Scarzy/3YP-Noise-Cancelling-Headphones/reports/final_report/pcbcostings.tex

The costings of the components for the PCB.
The total cost came to \pounds196.90.

\begin{table}[H]
	\centering
	\begin{tabular}[c]{| l | l | l | p{50px} | l | l | l |}
		\hline
		\multicolumn{7}{|l|}{MicroControllers} \\
		\hline
		Item	& Component Name& Supplier & Part	& No.	& Unit  & Line \\
		\hline
		DSP	& tms320c6713bpyp200	& Farnell	& 1214441	& 1	& \pounds24.51	& \pounds29.42	\\
		Codec	& wm8988		& Farnell	& 1776294	& 2	& \pounds2.84	& \pounds6.82	\\
		Clock Gen.	& bu2796	& Farnell	& 1716138	& 2	& \pounds0.83	& \pounds1.99	\\
		Dual Op-Amp	& ap358sg	& Farnell	& 1825347	& 10	& \pounds0.08	& \pounds0.96	\\
		\hline
		\multicolumn{7}{|l|}{}\\
		\hline
		\multicolumn{7}{|l|}{Resistors} \\
		\hline
		Item	& Component Name& Supplier & Part	& No.	& Unit  & Line \\
		\hline
		10K\textohm	& r-10k	& Farnell	& 1469748	& 50	& \pounds0.013	& \pounds0.78	\\
		8K2\textohm	& r-8k2	& Farnell	& 9334904	& 50	& \pounds0.01	& \pounds0.60	\\
		1K\textohm	& r-1k	& Farnell	& 9332383	& 50	& \pounds0.025	& \pounds1.50	\\
		120\textohm	& r-120	& Farnell	& 9337059	& 50	& \pounds0.011	& \pounds0.66	\\
		55\textohm	& r-55	& Farnell	& 1500641	& 50	& \pounds0.015	& \pounds0.90	\\
		33\textohm	& r-33	& Farnell	& 1500704	& 50	& \pounds0.016	& \pounds0.96	\\
		8\textohm	& r-8	& Farnell	& 1577385	& 50	& \pounds0.047	& \pounds2.82	\\
		\hline
		\multicolumn{7}{|l|}{}\\
		\hline
		\multicolumn{7}{|l|}{Capacitors} \\
		\hline
		Item	& Component Name& Supplier & Part	& No.	& Unit  & Line  \\
		\hline
		220uF	& c-220u& Farnell	& 1865004	& 5	& \pounds1.10	& \pounds6.60	\\
		10uF	& c-10u	& Farnell	& 1658212	& 10	& \pounds0.115	& \pounds1.38	\\
		4u7F	& c-4u7	& Farnell	& 1759427	& 100	& \pounds0.018	& \pounds2.16	\\
		1uF	& c-1u	& Farnell	& 1759398	& 100	& \pounds0.006	& \pounds0.72	\\
		100nF	& c-0u1	& Farnell	& 1759123	& 100	& \pounds0.005	& \pounds0.60	\\
		1nF	& c-1n	& Farnell	& 1759088	& 100	& \pounds0.005	& \pounds0.60	\\
		8pF	& c-8p	& Farnell	& 1759051	& 100	& \pounds0.006	& \pounds0.72	\\
		\hline
		\multicolumn{7}{|l|}{}\\
		\hline
		\multicolumn{7}{|l|}{Connectors} \\
		\hline
		Item	& Component Name& Supplier & Part	& No.	& Unit  & Line \\
		\hline
		2 pin	& cn-header2	& Farnell	& 1248140	& 10	& \pounds0.106	& \pounds1.24	\\
		8 pin	& cn-header2x4	& Farnell	& 1759051	& 8	& \pounds0.98	& \pounds9.41	\\
		14 pin	& cn-header2x7-box	& Farnell	& 8395926	& 2	& \pounds0.72	& \pounds1.73	\\
		Jack	& cn-st-jack	& Farnell	& 1217016	& 2	& \pounds1.36	& \pounds3.26	\\
		\hline
		\multicolumn{7}{|l|}{}\\
		\hline
		\multicolumn{7}{|l|}{Miscellaneous} \\
		\hline
		Item	& Component Name& Supplier & Part	& No.	& Unit  & Line \\
		\hline
		3.3V Regulator	& ld1117s33	& Farnell	& 1467779	& 2	& \pounds0.71	& \pounds1.71	\\
		1.2V Regulator	& ld1117s12	& Farnell	& 1467778	& 2	& \pounds1.02	& \pounds2.45	\\
		12MHz Crystal	& xtal-12m	& Farnell	& 1652551	& 2	& \pounds0.32	& \pounds0.77	\\
		Red LED		& led-red-0603	& Farnell	& 1465988	& 10	& \pounds0.23	& \pounds2.76	\\
		PCB		&	 	& PCB-Train	& 		& 2	& \pounds78.16	& \pounds78.16	\\
		JTAG Cable	&		& FTDI		& C232HM-DDHSL-0& 1	& \pounds18.50	& \pounds22.20	\\
		Headphones	&		& Play.com	& 3432806	& 1	& \pounds12.99	& \pounds12.99	\\
		\hline
	\end{tabular}
	\caption{Costs involved in the PCB production. Prices correct at time of purchase, line cost includes VAT, unit cost may not}
	\label{tab:pcbcostings}
\end{table}
