Scarzy/3YP-Noise-Cancelling-Headphones/reports/final_report/schematicappendix.tex

\label{appendix:schematics}
The schematics of the produced PCB.

\includepdf[pages=-,fitpaper=true,pagecommand={\thispagestyle{plain}}]{./sch/overview.pdf}
\includepdf[pages=-,fitpaper=true,pagecommand={\thispagestyle{plain}}]{./sch/codec.pdf}
\includepdf[pages=-,fitpaper=true,pagecommand={\thispagestyle{plain}}]{./sch/power.pdf}
\includepdf[pages=-,fitpaper=true,pagecommand={\thispagestyle{plain}}]{./sch/dsp.pdf}
\includepdf[pages=-,fitpaper=true,pagecommand={\thispagestyle{plain}}]{./sch/analogue.pdf}
\includepdf[pages=-,fitpaper=true,pagecommand={\thispagestyle{plain}}]{./sch/sigcond.pdf}
