Scarzy/3YP-Noise-Cancelling-Headphones/reports/final_report/final.tex

\documentclass[a4paper, 12pt]{report}
\usepackage{fullpage}
\usepackage{graphicx}
\usepackage{float}
\usepackage{fixltx2e}
\usepackage{rotating}
\usepackage{textcomp}
\usepackage{multirow}
\usepackage[final]{pdfpages}

\begin{document}
\input{frontpage}

\abstract{\input{abstract}}
\addcontentsline{toc}{section}{Abstract}
\setcounter{page}{2}

\tableofcontents
\addcontentsline{toc}{section}{Contents}

\listoffigures
\addcontentsline{toc}{section}{List of Figures}

\listoftables
\addcontentsline{toc}{section}{List of Tables}

\chapter*{Acknowledgements}
\input{acknowledgements}
\addcontentsline{toc}{section}{Acknowledgements}

\chapter{Introduction}
\input{description}

\chapter{Background}

\input{previouslyinthisthread}

\input{philipsphones}

\input{psychoacoustics}

\chapter{Planning}

\input{projmanagement}

\input{correlation}

\input{lms}

\input{pcbplan}

\input{dspvsfpga}

\chapter{Modelling}
\input{matlabmodelling}
\input{hardwaremodelling}

\chapter{Implementation}

\input{pcb}

\input{softimple}

\chapter{Testing}

\input{testhard}

\input{testsoft}

\chapter{Evaluation}

\input{evaluation}

\input{further}

\nocite{*}
\bibliographystyle{plain}
\bibliography{sources}

\appendix
\chapter{Project Brief}
\includepdf[pages=-,fitpaper=true,pagecommand={\thispagestyle{plain}}]{./brief.pdf}
\chapter{Weekly Tracker Samples}
\input{weeklytracker}
\chapter{Schematics}
\input{schematicappendix}
\chapter{PCB Costings}
\input{pcbcostings}
\chapter{Testing}
\input{resultsappendix}
\chapter{ICA}
\input{ica}

\chapter{CD README}
\input{cdcontents}
\end{document}
