Scarzy/3YP-Noise-Cancelling-Headphones/reports/progress_report/dspvsfpga.tex

\section{Hardware}
There are many alternative ways this system could be implemented, and various different pieces of hardware that could support it.
Three of these are a Digital Signal Processor (DSP), a Field-Programmable Gate Array (FPGA), and an Application Specific Integrated Circuit (ASIC).
Each of these have their own benefits and downsides.
\\
\\
Some considerations need to be taken into account while comparing these various approaches.
As mentioned previously, there is a very short period of time in which the processing can be achieved, therefore the device must be able to operate at a suitably high speed.
Also the algorithm will still be under development in parallel with the hardware, as such it needs to be easily configurable.
\\
\\
The DSP is in essence a standard processor just with a couple of optimisations for data processing.
As such it operates like a standard processor, instructions are loaded from memory and executed sequentially, and all the I/O are fixed.
This sequential method has some rather significant effects on the speed, as there can be no parallelization between tasks.
This means that the speed of processing is highly dependent on the clock speed.
However, the fact that the I/O pins are in a fixed location gives it a huge advantage over alternatives, in that it can be placed on a PCB and the code being run can be changed drastically without ever requiring to modify the PCB.
The code can also be modified whilst the chip is in the circuit, allowing the algorithm to be worked on alongside the PCB being produced rather than requiring the PCB to be produced later on.
\\
\\
On the other hand, FPGAs are just large blocks of programmable logic.
This makes the FPGA operate significantly faster than the DSP as operations can now be easily run in parallel and are less dependant on the clock.
Similarly to the DSP, the FPGA can also be reprogrammed in circuit.
However these advantages don't come without their trade-offs.
The pin layout of the chip can change drastically at each reprogramming, meaning that the PCB might be required to change to suit.
The amount of logic contained in the FPGA makes this unlikely as there is a certain amount of redundancy, but it is still a possibility.
While a constraint file can be used to define which pins achieve what functionality, this is sometimes unachievable depending on the functionality required.
The signal passing through any extra logic introduces an additional delay in the processing too, reducing the speed benefit.
Another downside is that the algorithm requires storing of value in memory, and creating a RAM segment will use a huge portion of the available logic.
They are also a lot more power hungry.
\\
\\
ASICs, when designed well, are amazingly fast.
They give an incredible amount of control over the speed that can be achieved and the techniques that can be employed.
They also have minimal power usage as there is no unnecessary circuitry.
This is achieved by giving the designer a blank square of silicon and allowing them to design the system as far down as the transistor level.
This approach is not feasible for this project as, although it would work brilliantly in a consumer device, the development process is a lot more complex and suspect to delays, the design is also a lot more error prone.
Getting the chip produced is a lot more expensive than either of the other two alternatives, and once it is produced it is impossible to make changes.
\\
\\
After comparing these three options, this project will be based on a DSP.
This is due to the larger memory capacity and flexibility in the modifications that can be made.
The knock-on effect of this is that the software side must be highly optimised for speed, in order to counteract the slowness of the DSP.
