Scarzy/3YP-Noise-Cancelling-Headphones/reports/final_report/projmanagement.tex

\section{Project Management}
Due to this project being spread over almost an entire year, a certain amount of management needed to be maintained in order to ensure that work did not fall behind.

\subsection{Gantt Chart}
One method used in this project to keep track of progress was a Gantt Chart.
This is a way of showing what work should be done when, and allowing tasks which overrun to be highlighted.
\\
\begin{sidewaysfigure}
	\centering
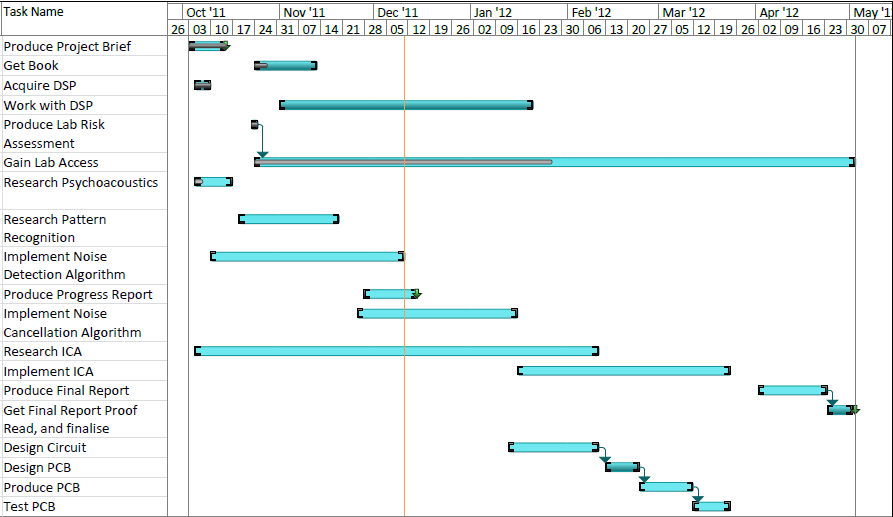
[picture p121: reports/final_report/img/ganntori.png]
	
	\caption{The Gantt chart for this project as originally produced}
	\label{fig:gannt}
\end{sidewaysfigure}

\noindent
The Gantt chart shown in figure~\ref{fig:gannt} changed regularly as time got reallocated and tasks got completed ahead or behind schedule.
By the end of the project, the Gantt chart stood as shown in figure \ref{fig:newgannt}.
\\
\begin{sidewaysfigure}
	\centering
	
	\caption{The Gantt chart for this project showing actual progress}
	\label{fig:newgannt}
\end{sidewaysfigure}

\noindent
A few differences can be seen between these two charts.
The majority of the differences are tasks that have been achieved, however it does show that some tasks ran behind schedule.
Another difference is the addition of some tasks, such as the production of costings to apply for a budget increase.
The general reason for tasks running behind schedule was due to problems in debugging, and not allowing suitable margins for fixing problems that arose.

\subsection{Weekly Tracker}
While Gantt Charts clearly show what should be done and when, they are less representative of what should be achieved in the short term.
As such the `Weekly Tracker' was developed in order to show what tasks needed to be achieved in the week, and to follow whether the project was on track on a weekly basis.
\\
\\
This is a sheet containing a list of tasks to be worked on during each week, including a review date on which the progress of each of these tasks would be noted and compared against the required progress.
\\
\\
Each task had a task name; also each task had space for notes at the beginning and end of the week.
Along with this, each task had a rank from 0 to 10 for minimum acceptable completion.
This is essentially the minimum percentage of the task that was required to have been completed by the end of the week to remain on track.
Using a rank below 10 here allowed for tasks to span multiple weeks, by increasing the required rank while progressing through the project.
There was also a rank for task completion.
This rank was out of the entire task, not just the amount required for the week, allowing progress beyond that expected for that week to be noted.
In the event of progression beyond the scope required by the overall task, this would be ranked as `+'.
At the end of the week on the review date, the sum of the differences between required and completed ranks gave a score for the week.
A negative score denoted that the project was behind schedule, whereas a positive score denoted that it was ahead of schedule.
A score of 0 indicated that it was on schedule.
An example of these can be seen in appendix \ref{appendix:weeklytracker}.
\\
\\
Table \ref{tab:scorings} shows the scores achieved on these weekly trackers.
\begin{table}[H]
	\centering
	\begin{tabular}[c]{| c | l | l | c |}
		\hline
		Sheet	& Start	& End	& Score \\
		\hline
		1	& 05/10/2011	& 09/10/2011	& -6	\\
		2	& 10/10/2011	& 16/10/2011	& -2	\\
		3	& 16/10/2011	& 23/10/2011	& -1	\\
		4	& 23/10/2011	& 30/10/2011	& -5	\\
		5	& 01/11/2011	& 06/11/2011	& -10	\\
		6	& 09/11/2011	& 13/11/2011	& -2	\\
		7	& 13/11/2011	& 20/11/2011	& -12	\\
		8	& 21/11/2011	& 27/11/2011	& -6	\\
		9	& 27/11/2011	& 04/12/2011	& -6	\\
		10	& 04/12/2011	& 11/12/2011	& 0	\\
		11	& 11/12/2011	& 18/12/2011	& -1	\\
		12	& 18/12/2011	& 08/01/2012	& -7	\\
		13	& 08/01/2012	& 29/01/2012	& -7	\\
		14	& 29/01/2012	& 05/02/2012	& -3	\\
		15	& 05/02/2012	& 12/02/2012	& 0	\\
		16	& 12/02/2012	& 19/02/2012	& -1	\\
		17	& 19/02/2012	& 26/02/2012	& -3	\\
		18	& 26/02/2012	& 04/03/2012	& 7	\\
		19	& 26/02/2012	& 04/03/2012	& 7	\\
		20	& 04/03/2012	& 11/03/2012	& -5	\\
		21	& 11/03/2012	& 18/03/2012	& -10	\\
		22	& 18/03/2012	& 01/04/2012	& -7	\\
		23	& 01/04/2012	& 15/04/2012	& -5	\\
		24	& 15/04/2012	& 22/04/2012	& -4	\\
		25	& 22/04/2012	& 29/04/2012	& -1	\\
		26	& 29/04/2012	& 02/05/2012	& 0	\\
		\hline
	\end{tabular}
	\caption{Scores of the weekly tracker}
	\label{tab:scorings}
\end{table}

\noindent These scores show that the project was often behind schedule.
This was largely due to not fully anticipating how long certain aspects of the project would take, and unforeseen external factors.
Also the design of the weekly tracker doesn't particularly allow for scoring ahead of schedule.
This is because when work is completed significantly beyond the scope of the task an additional score of only 1 can be achieved, whereas negative scores are easier to achieve.

\subsection{Milestones}
In order to determine the state of the project, a collection of milestones were set.
At each one the system would be able to demonstrate a level of functionality.
This allowed for any major progress in the system to be noted and allowed the progress of the system to be observed.
Each milestone had a list of requirements which had to be met before it could be classed as achieved.
These milestones did not have to be met in the order stated, and some of them were worked on in parallel, though in most cases the milestones built on the previous ones.

\begin{table}[H]
	\centering
	\begin{tabular}[c]{| c | l | c |}
		\hline
		No.	& Milestone		& Achieved? \\
		\hline
		1	& Record/replay audio	& X \\
		2	& Cancellation algorithm & X \\
		3	& Cancellation on DSP	& X \\
		4	& Create PCB		& X \\
		5	& LMS algorithm		& X \\
		6	& LMS on DSP		& X \\
		7	& Add ICA		& \\
		\hline
	\end{tabular}
	\caption{The milestones set for the project}
	\label{tab:milestones}
\end{table}
