Scarzy/3YP-Noise-Cancelling-Headphones/reports/progress_report/projmanagement.tex

\section{Project Management}
Due to this project being spread over almost an entire year, a certain amount of management needs to be maintained in order to ensure that work does not fall behind.

\subsection{Gannt Chart}
One method used in this project to keep track of progress is a Gannt Chart.
This is a way of showing what work should be being done when, and allowing tasks which overrun to be easily noticed.
\\
\begin{sidewaysfigure}
	\centering
	
	\caption{The Gannt chart for this project as originally produced}
	\label{fig:gannt}
\end{sidewaysfigure}

\noindent
The Gannt chart shown in figure~\ref{fig:gannt} changes regularly as time gets reallocated and tasks get completed ahead or behind schedule.
The current up to date version of this chart can be seen in figure~\ref{fig:newgannt}
\\
\begin{sidewaysfigure}
	\centering
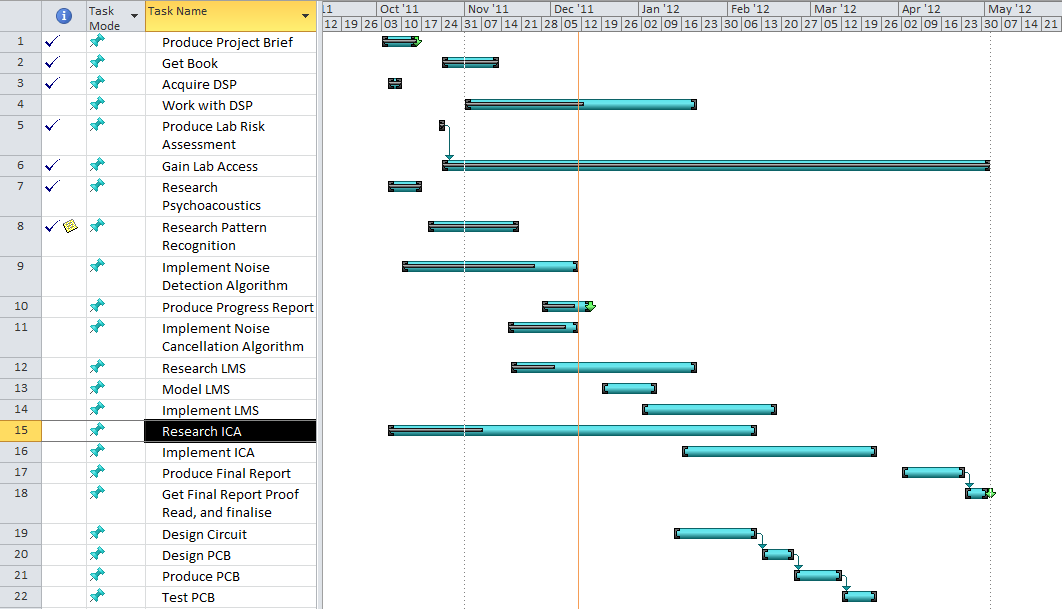
[picture p123: reports/progress_report/img/ganntnew.png]
	
	\caption{The up to date Gannt chart for this project}
	\label{fig:newgannt}
\end{sidewaysfigure}

\noindent
A few differences can be seen between these two charts.
The majority of the differences are tasks that have been achieved, however the most significant difference is the introduction of the sections on LMS which will be discussed in section~\ref{sec:LMS}.

\subsection{Weekly Tracker}
While Gannt Charts clearly show what should be being done and when, they are less representative of what should be being achieved in the short term.
As such the `Weekly Tracker' was developed in order to show what tasks needed to be achieved in the week, and to follow whether the project was on track on a weekly basis.
\\
\\
This is a sheet containing a list of tasks to be worked on during the coming week, including a review date on which the progress of each of these tasks would be noted and compared against the required progress.
\\
\\
Each task has a task name; also each task has space for notes at the beginning and end of the week.
Along with this, each task has a rank from 0 to 10 for minimum acceptable completion.
This is essentially the minimum percentage of the task that required to have been completed by the end of the week to remain on track.
Using a rank below 10 here allows for tasks to span multiple weeks, by increasing the required rank while progressing through the project.
There is also a rank for task completion.
This rank is out of the entire task, not just the amount required for the week, allowing progress beyond that expected for that week to be noted.
In the event of progression beyond the scope required by the overall task, this would be ranked as `+'.
At the end of the week on the review date, the sum of the differences between required and completed ranks would give a score for the week.
A negative score would denote that the project is behind schedule, whereas a positive score denotes that it is ahead of schedule.
A score of 0 indicating that it is on schedule.

\subsection{Milestones}
In order to determine the state of the system, a collection of milestones has been set.
At each one the system would be able to demonstrate a level of functionality.
This would allow any major progress in the system to be noted and would allow the progress of the system to be observed.
Each milestone has a list of requirements which have to be met before it can be classed as achieved.
These milestones do not have to be met in the order stated, and some of them will be worked on in parallel, though in most cases the milestones build on the previous ones.

\begin{table}[H]
	\centering
	\begin{tabular}[c]{| c | l | c |}
		\hline
		No.	& Milestone		& Achieved? \\
		\hline
		1	& Record/replay audio	& X \\
		2	& Cancellation algorithm & X \\
		3	& Cancellation on DSP	& X \\
		4	& Create PCB		& \\
		5	& LMS algorithm		& \\
		6	& LMS on DSP		& \\
		7	& Add ICA		& \\
		\hline
	\end{tabular}
	\caption{The milestones set for the project}
	\label{tab:milestones}
\end{table}
