Scarzy/3YP-Noise-Cancelling-Headphones/reports/project_brief/goals.tex

\label{goals}
This project will take in an unwanted sound source and cancel it out from the sounds being heard. This will be achieved through the use of a Digital Signal Processor (DSP) with multiple sound inputs, and a single sound output capable of driving a set of headphones.
There will be a hardware component as well as a software component. The hardware component will be a DSP capable of completing the required analysis. This will be surrounded by circuitry capable of supporting the power requirements of the DSP, and the ability to interface suitable sound sources with the DSP.
The software component will do the actual cancelling. Both the heard sound and the nuisance sound will be compared in order to filter out the nuisance source. It will have to account for varying intensities of sound between the nuisance source and when it reaches the ears of the user, also the impulse response of the room will have to be taken into account, so that the multipath nature of sound waves will not cause unwanted distortion. This software component will have to be capable of running fast enough so that the DSP actually cancels, rather than applying the change after the sound has already been heard.
