Scarzy/3YP-Noise-Cancelling-Headphones/reports/final_report/img/weekfull.pdf

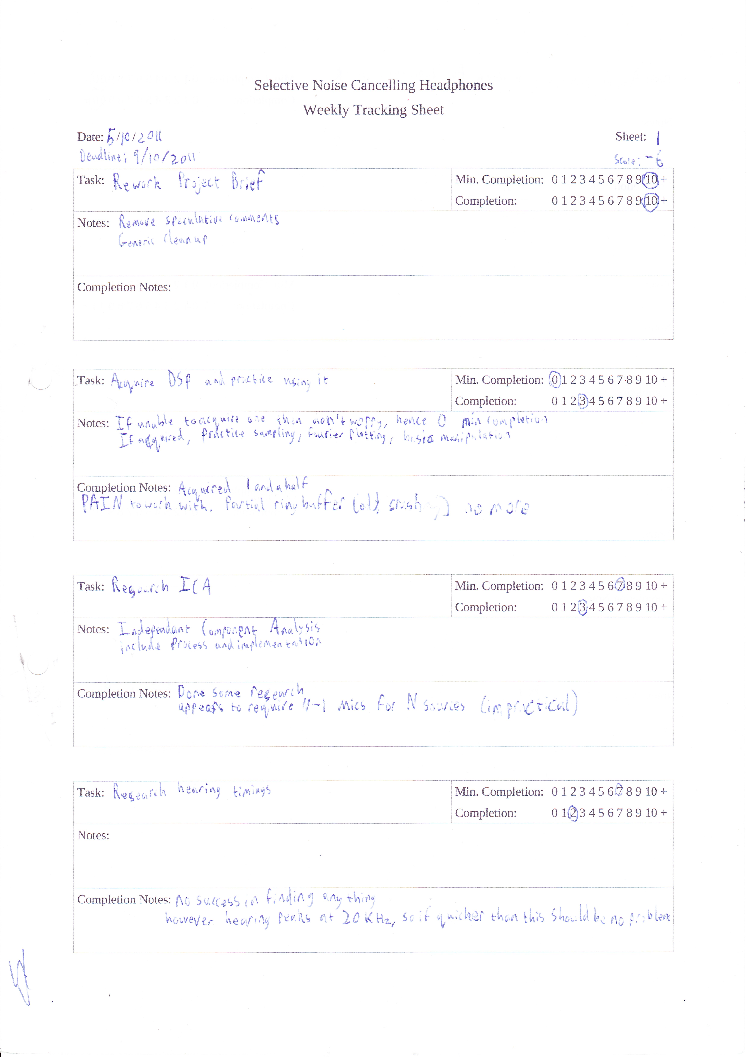
[picture p124: page 1]
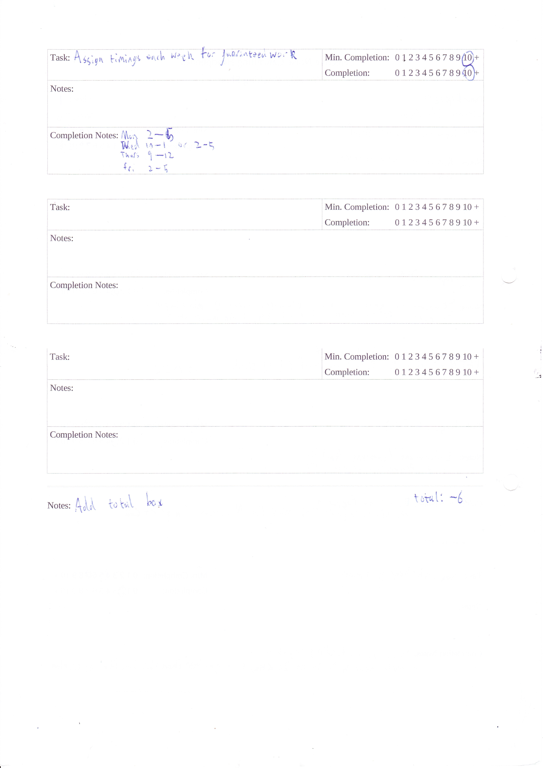
[picture p125: page 2]
