Scarzy/3YP-Noise-Cancelling-Headphones/reports/final_report/img/dsp.png

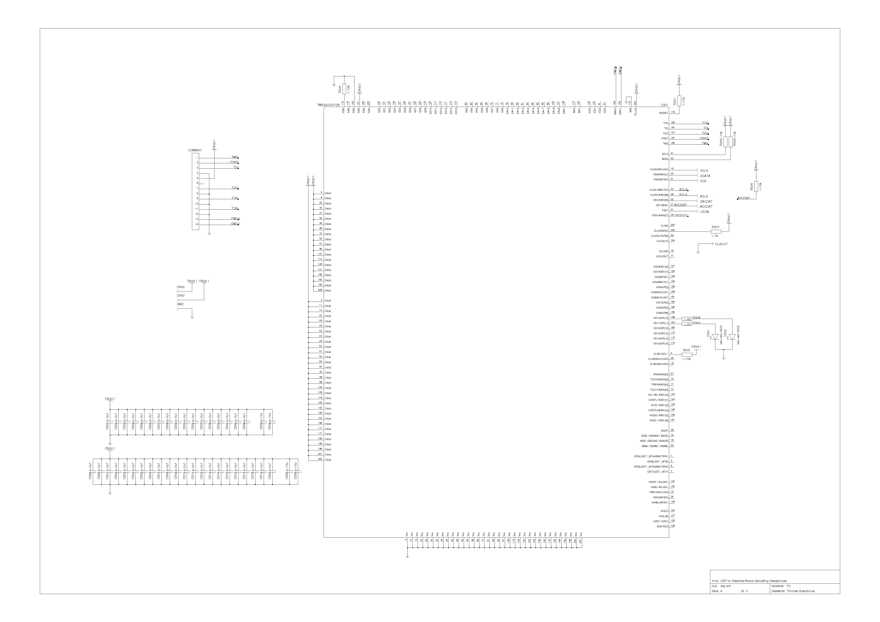
reports/final_report/img/dsp.png
