Scarzy/3YP-Noise-Cancelling-Headphones/reports/final_report/img/instrumentationamp.pdf

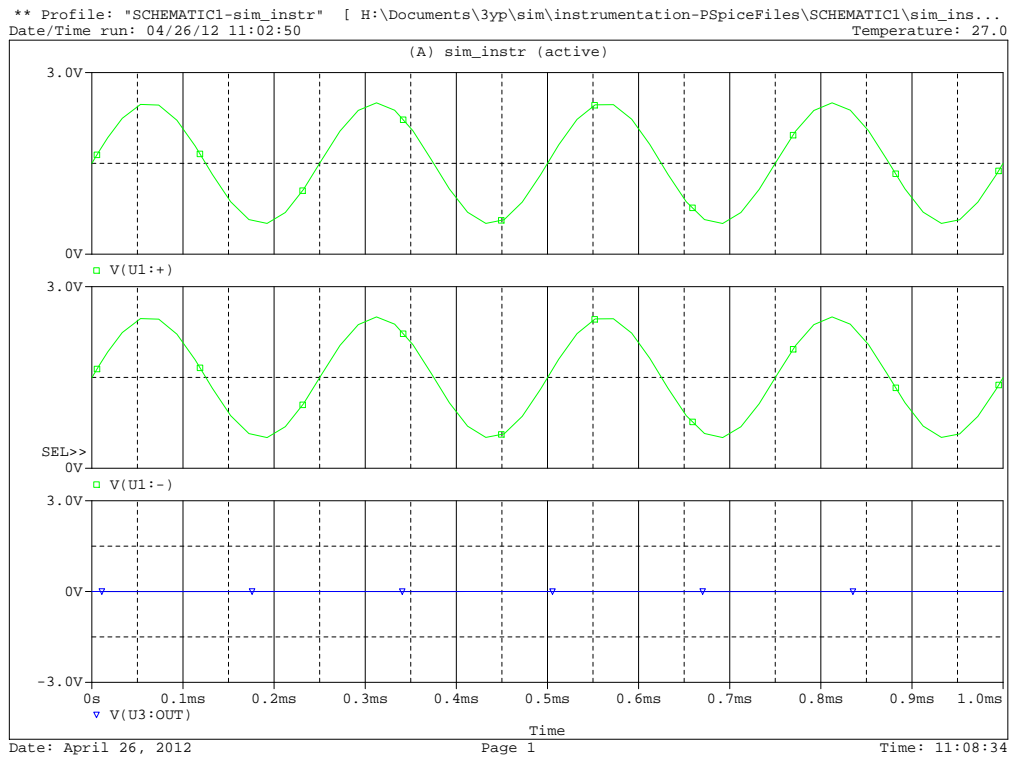
[picture p131: page 1]
Temperature: 27.0; Date: April 26, 2012; Page 1; Time: 11:08:34; (A) sim_instr (active); Time; V(U3:OUT); SEL>>

** Profile: "SCHEMATIC1-sim_instr" [ H:\Documents\3yp\sim\instrumentation-PSpiceFiles\SCHEMATIC1\sim_ins...
Date/Time run: 04/26/12 11:02:50
