Scarzy/3YP-Noise-Cancelling-Headphones/reports/final_report/sch/power.pdf

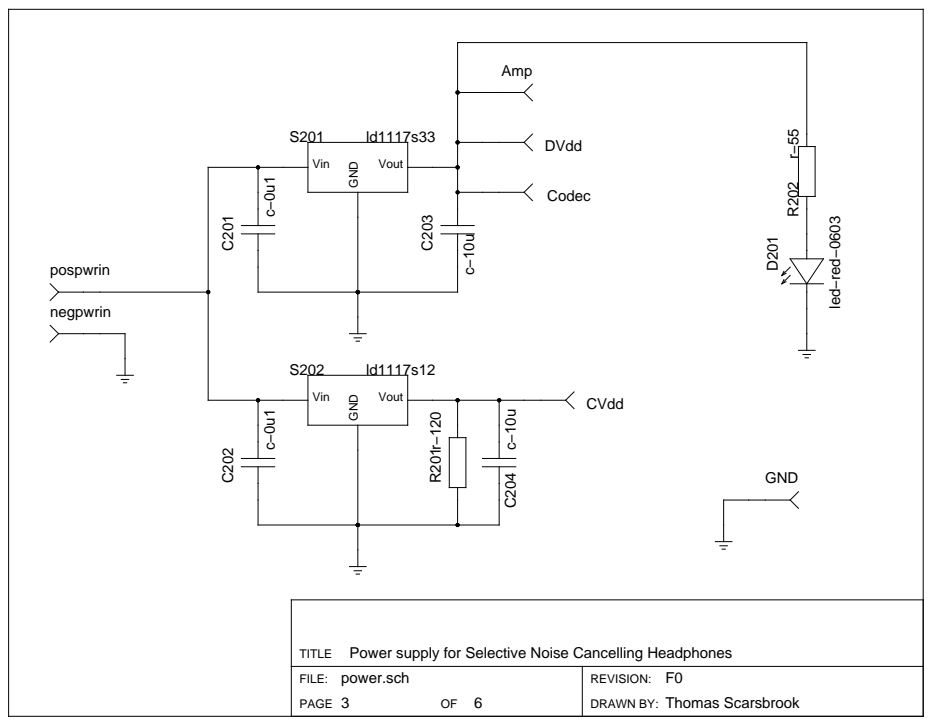
[picture p133: page 1]
GNDVin Vout; PAGE; DRAWN BY:; Thomas Scarsbrook

Power supply for Selective Noise Cancelling Headphones
