Scarzy/3YP-Noise-Cancelling-Headphones/reports/final_report/img/Full_Project_Gannt_final.pdf

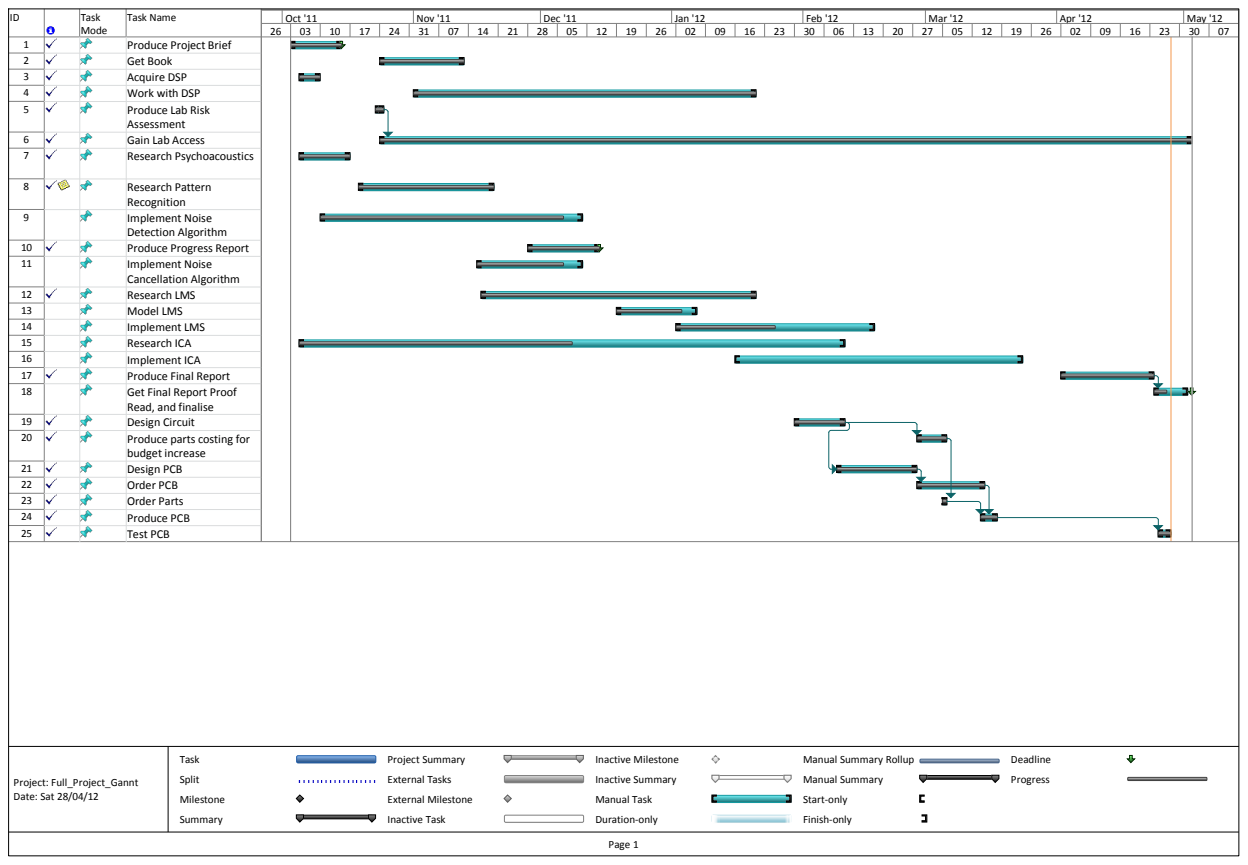
[picture p134: page 1]
Task; Mode; Task Name; Produce Project Brief; Get Book; Acquire DSP; Work with DSP; Produce Lab Risk; Assessment; Gain Lab Access; Research Psychoacoustics; Research Pattern; Recognition; Implement Noise; Detection Algorithm; Produce Progress Report; Cancellation Algorithm; Research LMS; Model LMS; Implement LMS; Research ICA; Implement ICA; Produce Final Report; Get Final Report Proof; Design Circuit; Produce parts costing for; budget increase; Design PCB; Order PCB; Order Parts; Produce PCB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

Read, and finalise

Manual Summary Rollup
Manual Summary
Start-only
Finish-only

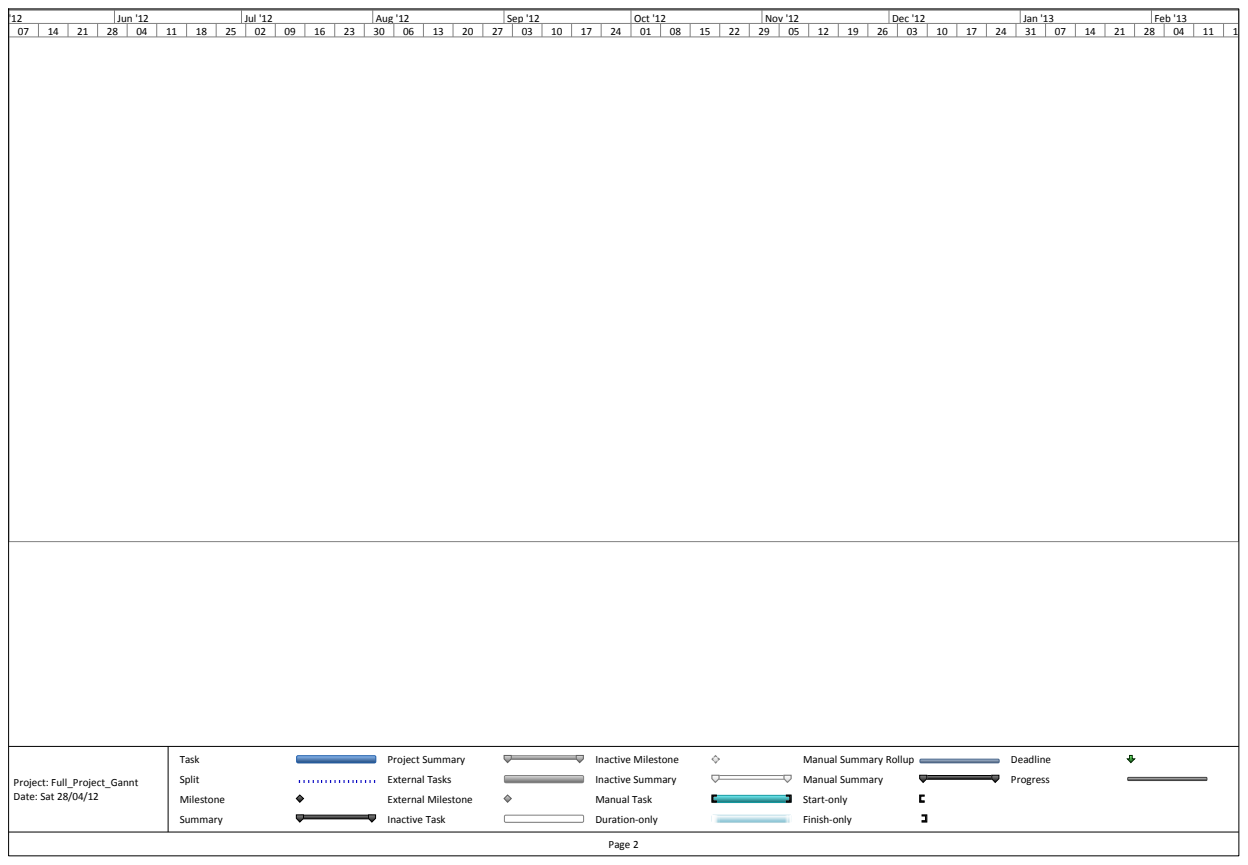
[picture p135: page 2]
May '12; Jun '12; Jul '12; Aug '12; Sep '12; Oct '12; Nov '12; Dec '12; Jan '13; Feb '13; Task; Split; Milestone; Summary; Project Summary; External Tasks; External Milestone; Inactive Task; Inactive Milestone; Inactive Summary; Manual Task; Duration-only; Deadline; Progress; Project: Full_Project_Gannt Date: Sat 28/04/12

Manual Summary Rollup
Manual Summary
Start-only
Finish-only
