Scarzy/3YP-Noise-Cancelling-Headphones/reports/final_report/img/signal_conditioning_sim.pdf

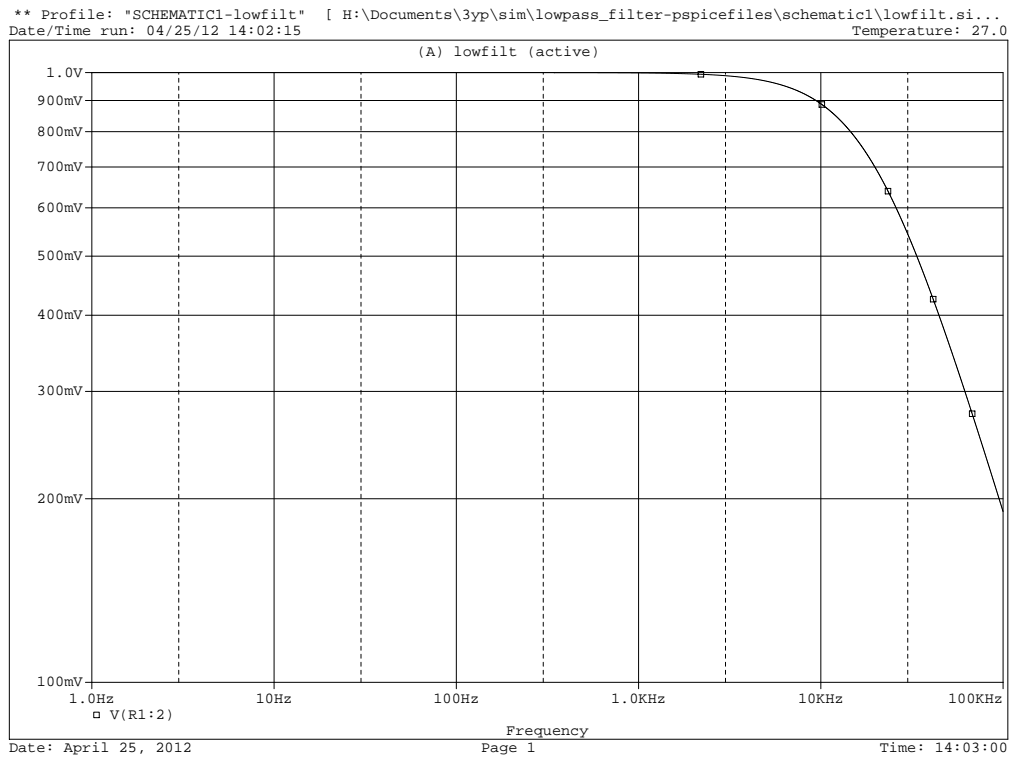
[picture p136: page 1]
Temperature: 27.0; Date: April 25, 2012; Page 1; Time: 14:03:00; (A) lowfilt (active); Frequency; 1.0KHz; 10KHz; 100KHz

** Profile: "SCHEMATIC1-lowfilt" [ H:\Documents\3yp\sim\lowpass_filter-pspicefiles\schematic1\lowfilt.si...
Date/Time run: 04/25/12 14:02:15
