Scarzy/3YP-Noise-Cancelling-Headphones/reports/final_report/img/hp.pdf

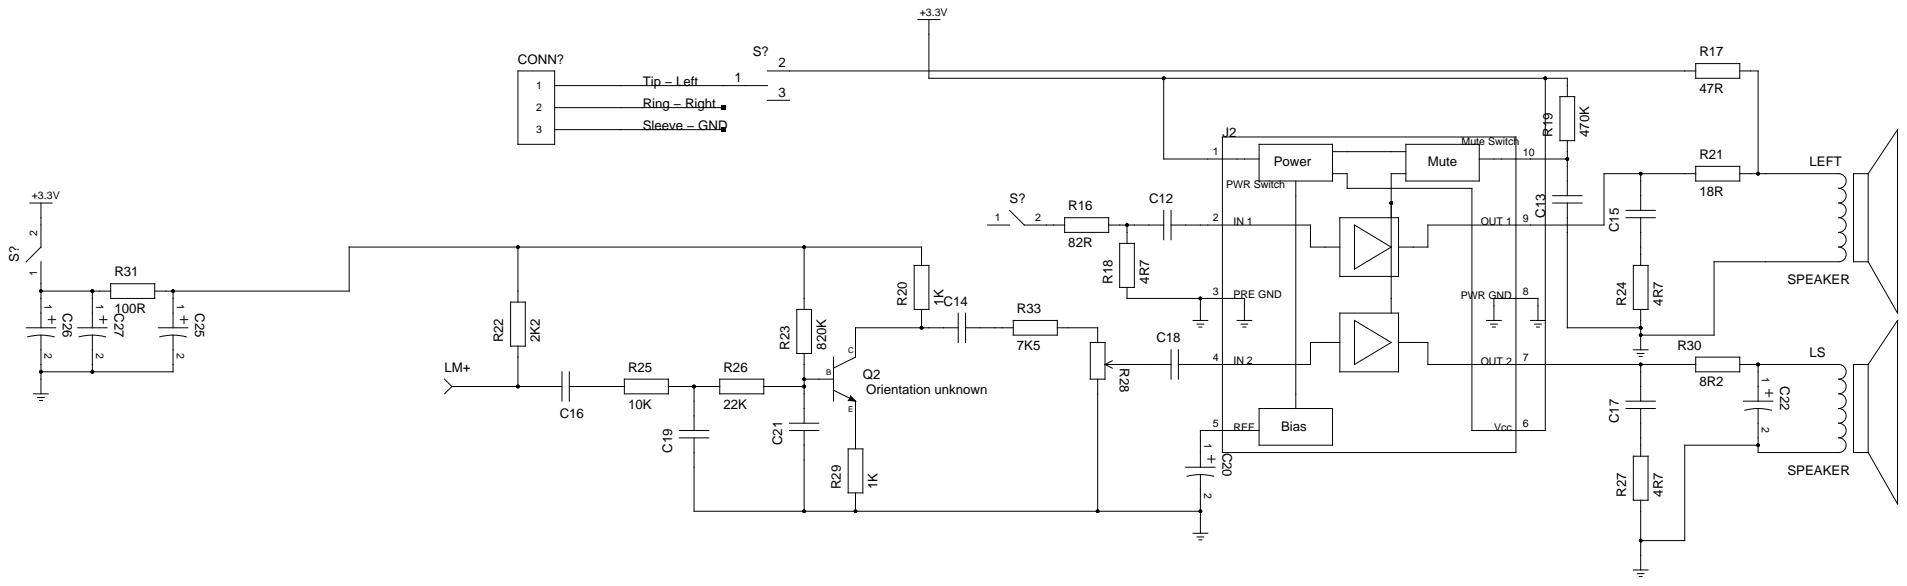
[picture p137: page 1]

8 PWR GND
