Scarzy/3YP-Noise-Cancelling-Headphones/reports/final_report/sch/analogue.pdf

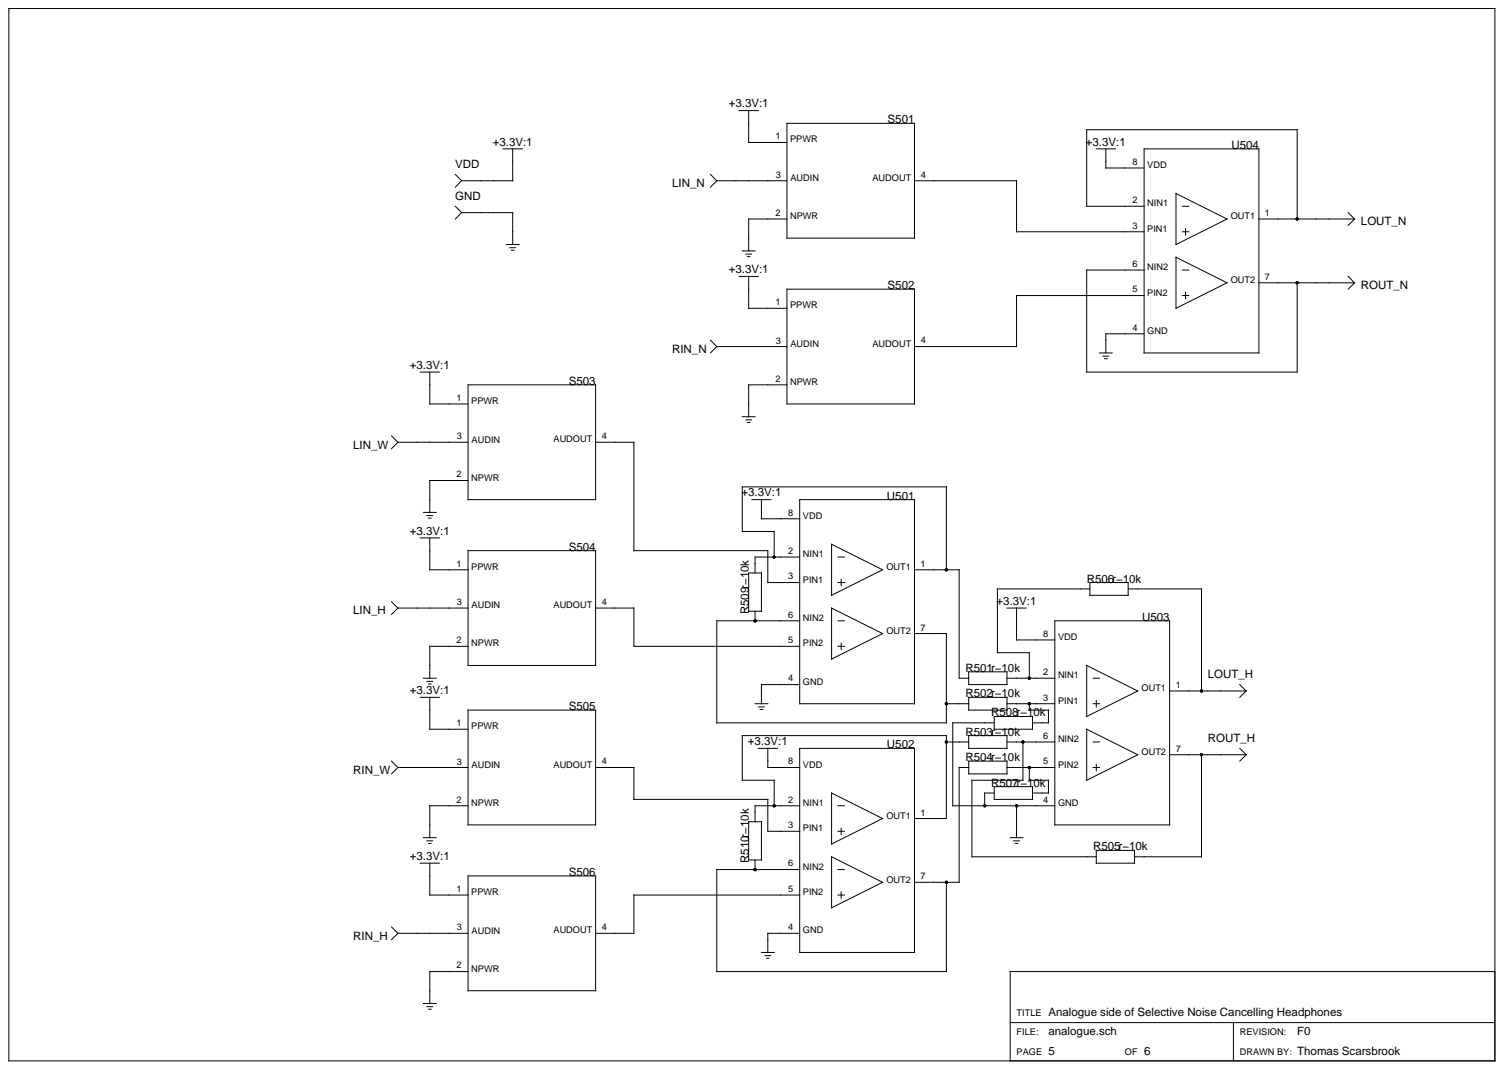
[picture p138: page 1]
4 AUDOUT 3; AUDIN; PAGE; DRAWN BY:; Thomas Scarsbrook

TITLE Analogue side of Selective Noise Cancelling Headphones
analogue.sch
