Scarzy/3YP-Noise-Cancelling-Headphones/reports/final_report/sch/codec.pdf

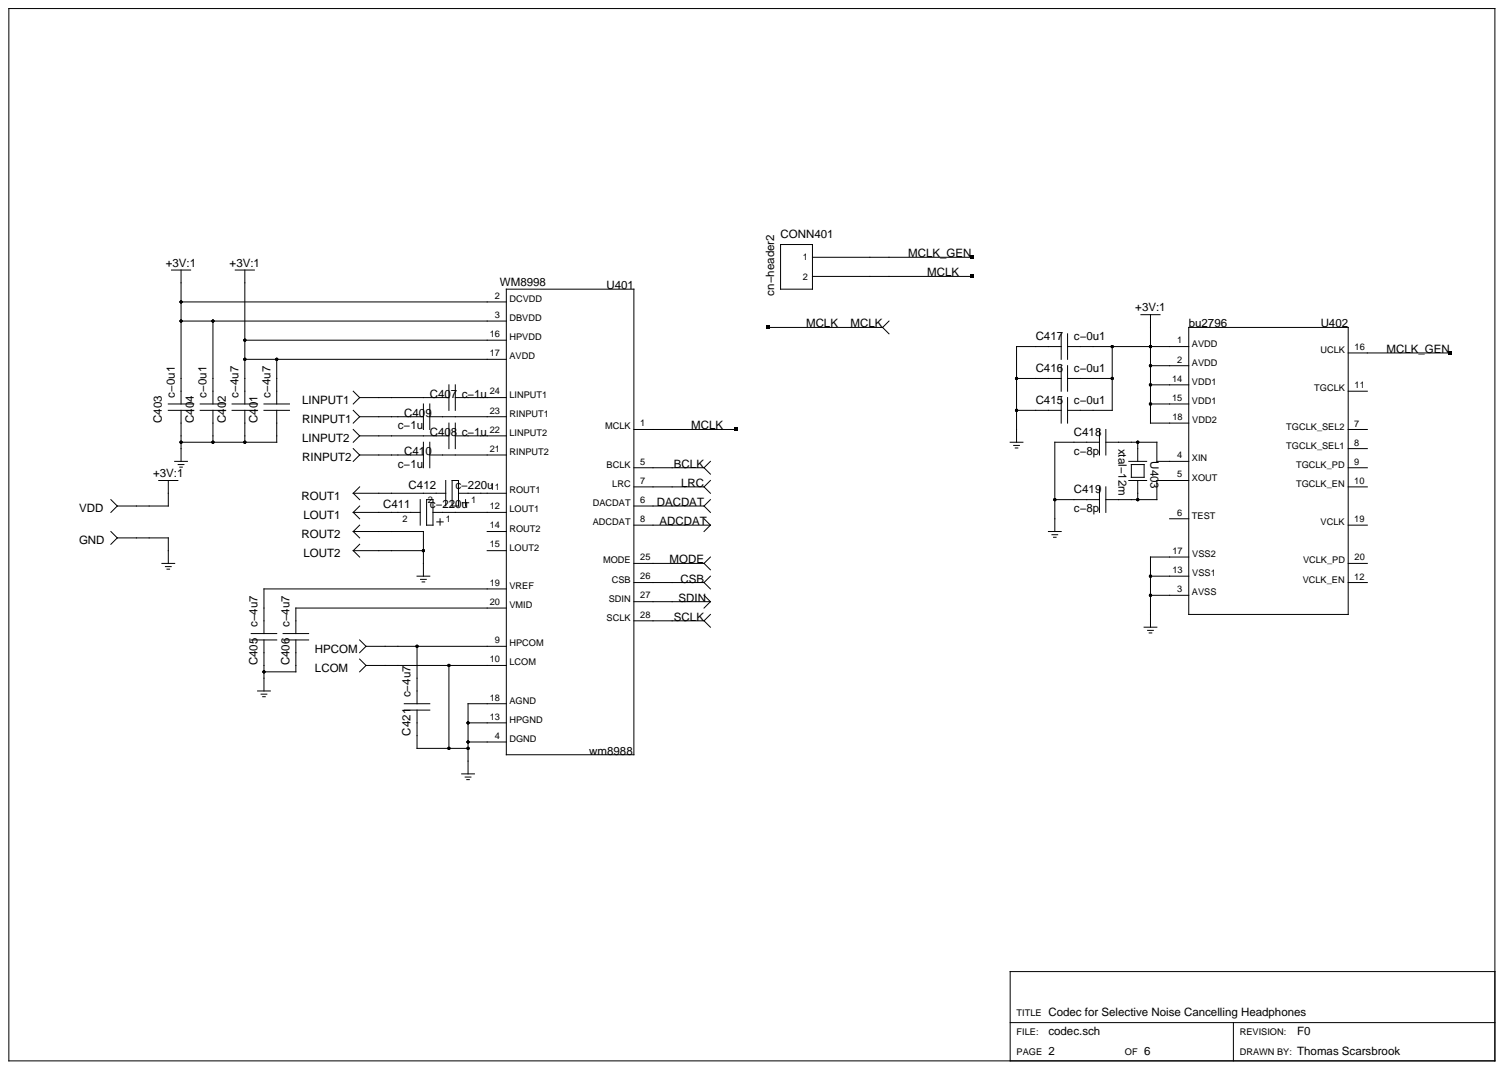
[picture p139: page 1]

Codec for Selective Noise Cancelling Headphones
TITLE
codec.sch
