Scarzy/3YP-Noise-Cancelling-Headphones/reports/final_report/sch/dsp.pdf

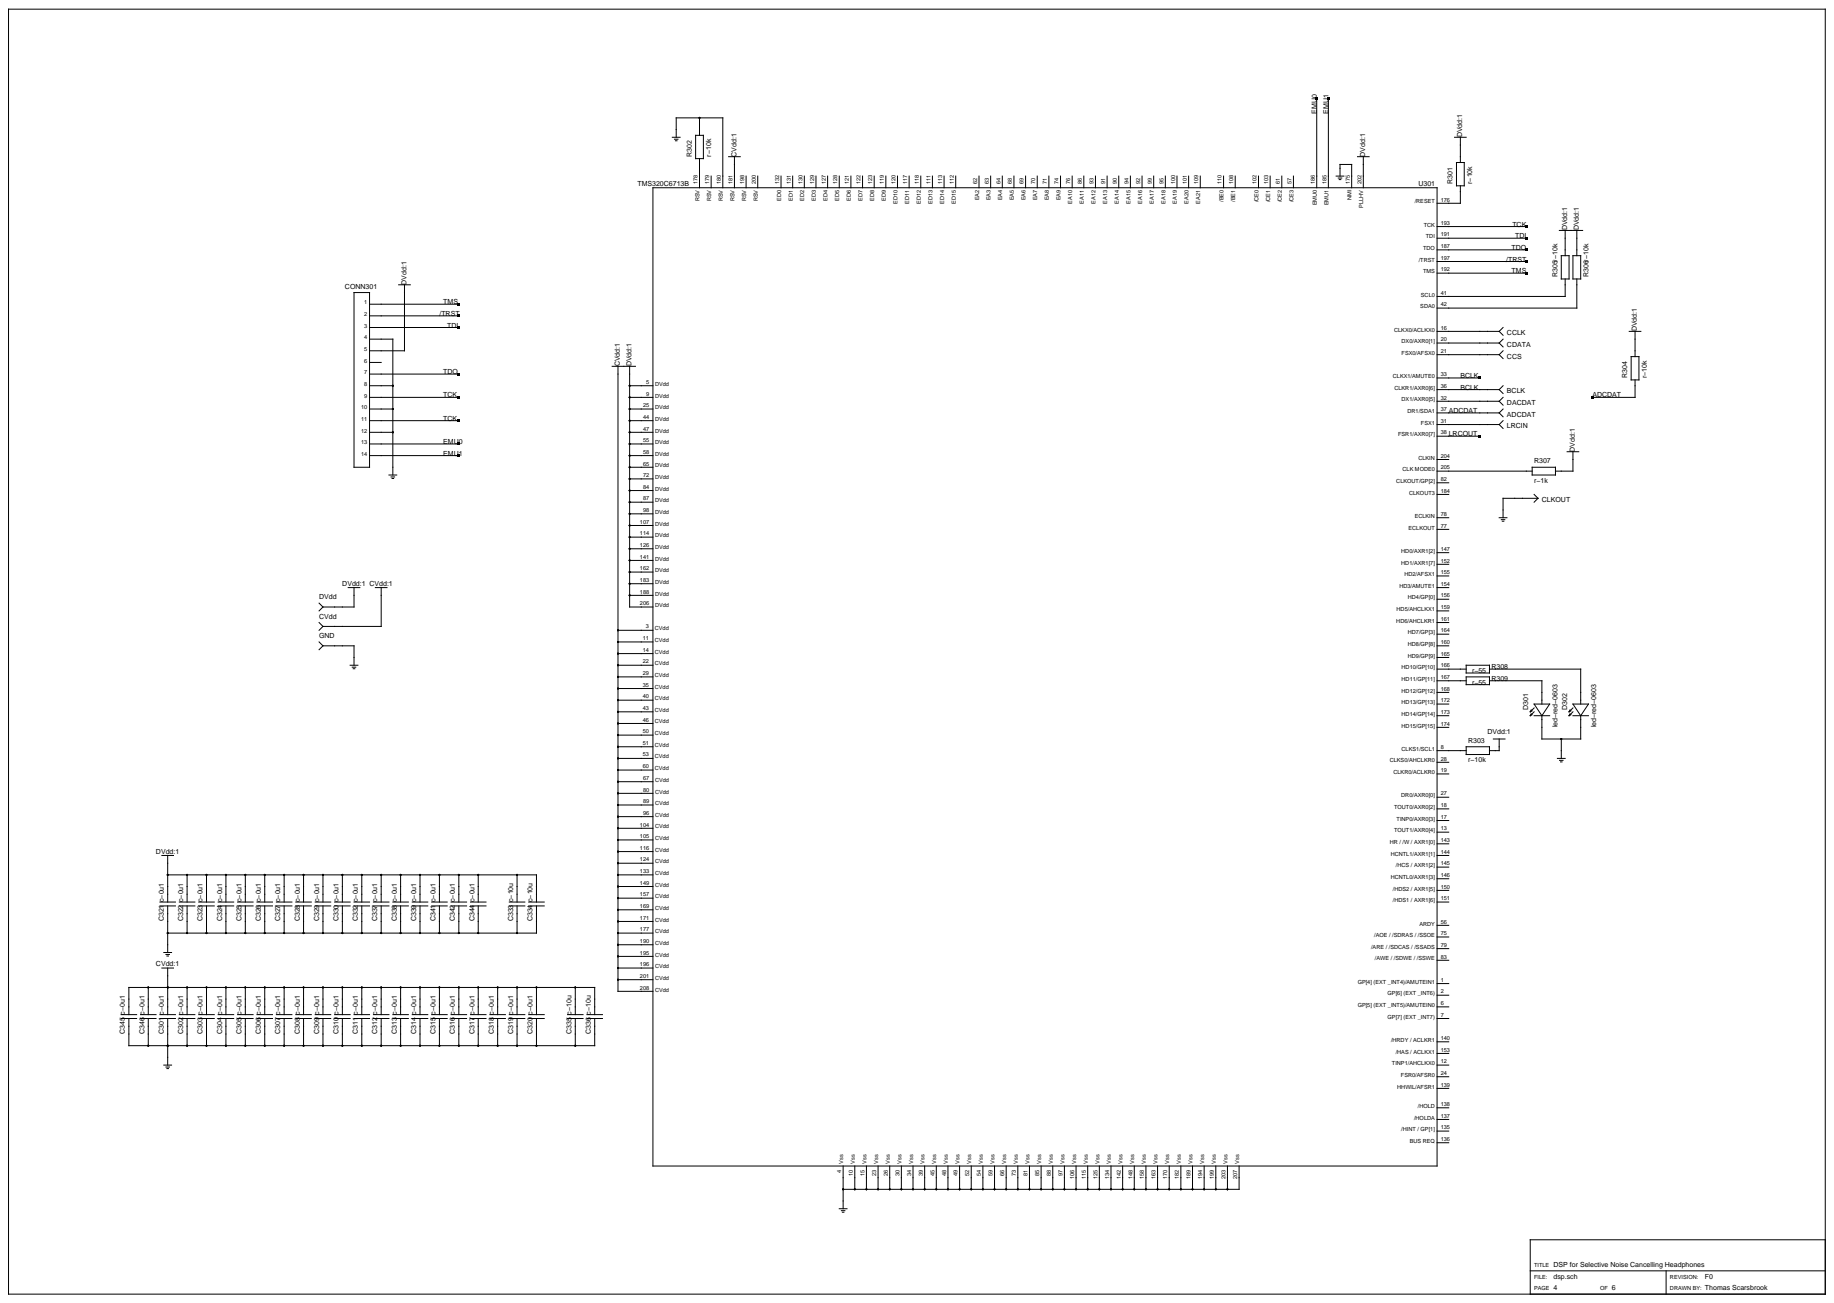
[picture p140: page 1]

DSP for Selective Noise Cancelling Headphones
TITLE
dsp.sch
