Scarzy/3YP-Noise-Cancelling-Headphones/reports/final_report/sch/overview.pdf

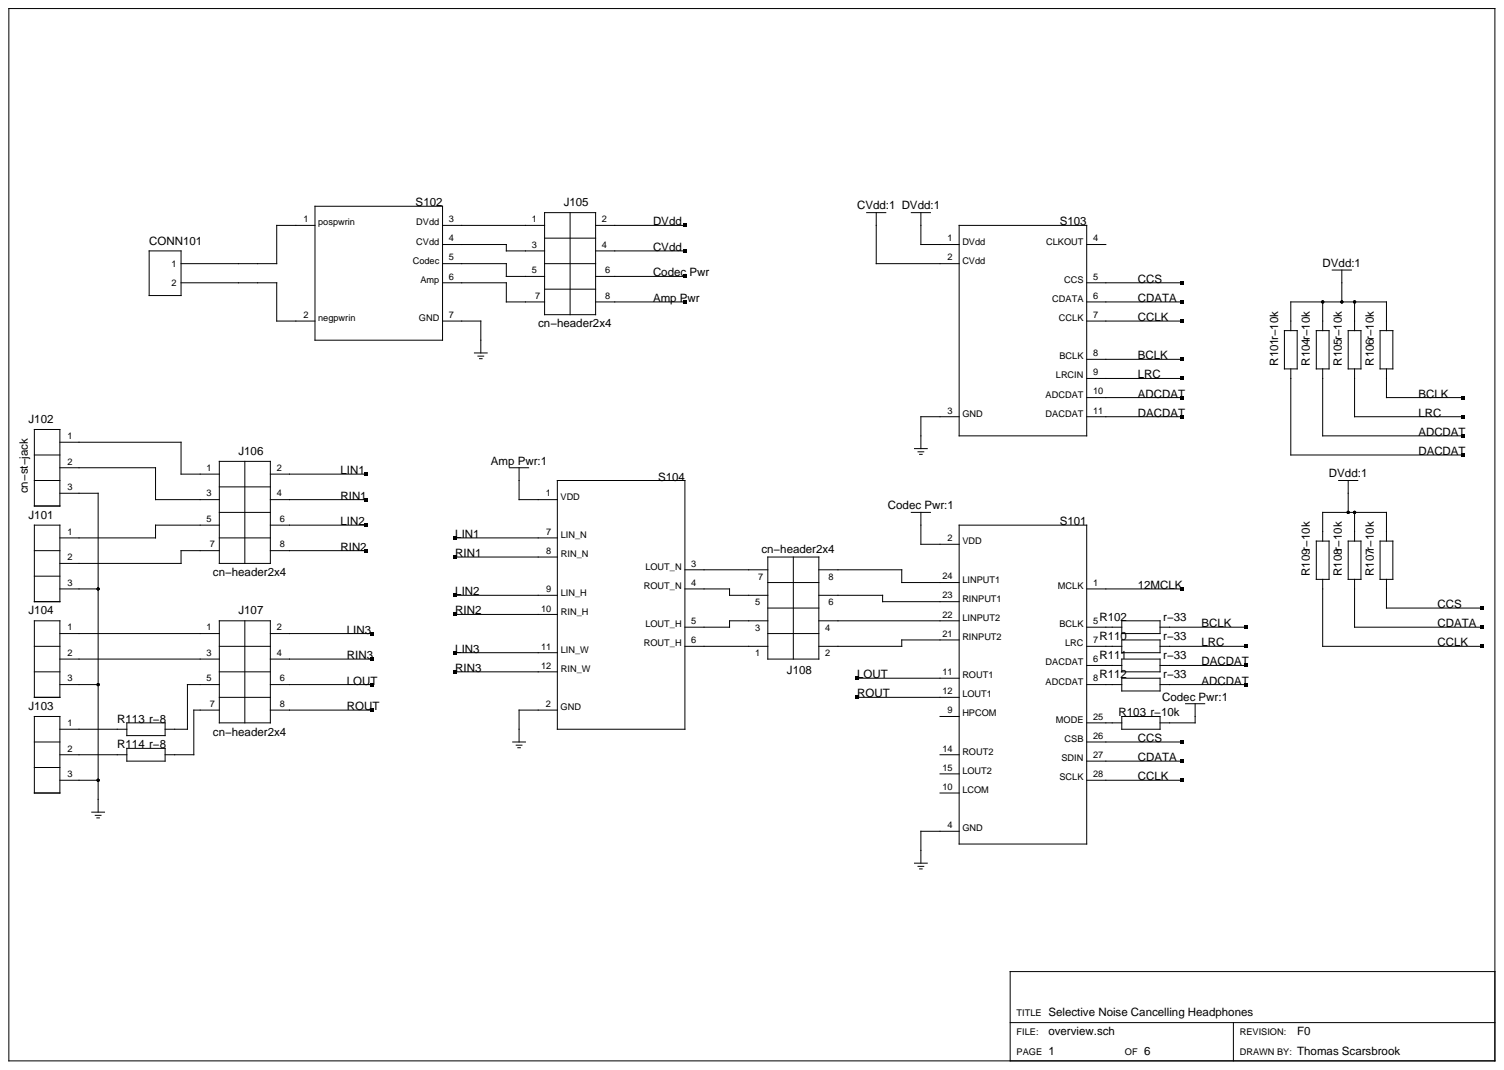
[picture p141: page 1]

Selective Noise Cancelling Headphones
TITLE
