Scarzy/3YP-Noise-Cancelling-Headphones/reports/final_report/sch/sigcond.pdf

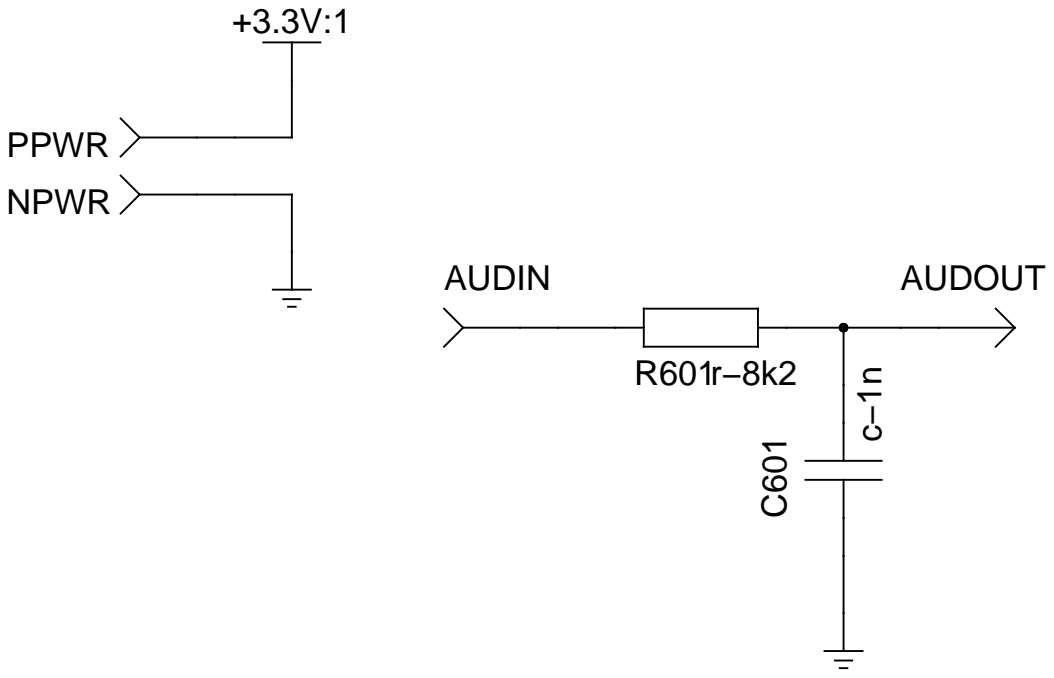
[picture p142: page 1]
PAGE; DRAWN BY:; Thomas Scarsbrook

TITLE Signal Conditioner for Selective Noise Cancelling Headphones
analogue−sig−cond−amp.sch
