Scarzy/3YP-Noise-Cancelling-Headphones/reports/final_report/img/dsp_decoupling.pdf

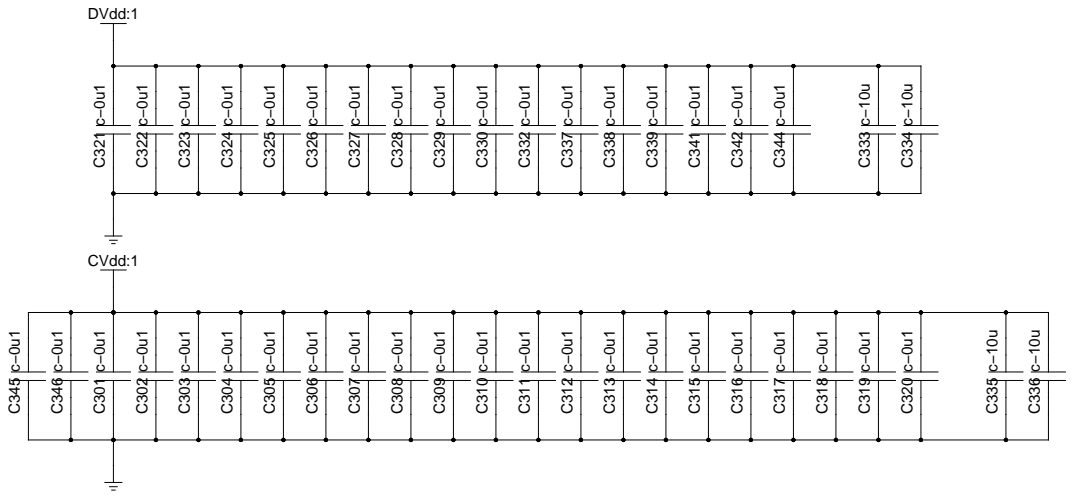
[picture p143: page 1]
