Scarzy/3YP-Noise-Cancelling-Headphones/reports/final_report/img/dsp_LEDs.pdf

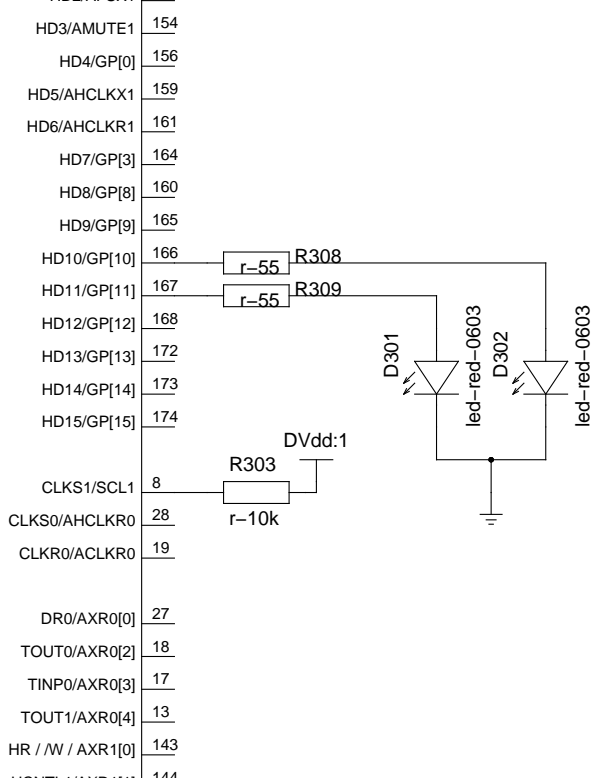
[picture p144: page 1]
HD2/AFSX1 155; 13 TOUT1/AXR0[4]; 18 TOUT0/AXR0[2]; 17 TINP0/AXR0[3]; HR / /W / AXR1[0]
