Scarzy/3YP-Noise-Cancelling-Headphones/(list of files, drawings)

Other design files:
work/schematics/overview.pcb
work/schematics/pcbrevs/overview_r0.pcb
work/schematics/pcbrevs/overview_r1.pcb
