Scarzy/3YP-Noise-Cancelling-Headphones/work/code/sigproc.h

#ifndef __SIG_PROC_H_
#define __SIG_PROC_H_

#include <math.h>
#include "ring.h"

#define CROSS_CORR_MAX_DELAY 200

void cancel(void * ring1, int16_t * ptr1in, void * ring2, int16_t *ptr2in, void * res, int16_t * ptrres);
void crosscorr(void * ring1, int16_t * ptr1in, void * ring2, int16_t * ptr2in, double * res, int16_t length, int16_t maxdel);
int dpeak(double * arr, int length);

#endif /* __SIG_PROC_H_ */
