Scarzy/3YP-Noise-Cancelling-Headphones/(commit log)

2011-10-05 Add a weekly progress tracker form, and a copy as a pdf for ease of printing
2011-10-08 Add a some code to create and support ring buffers
    Also contains code that works with the DSK6713, working with the LEDs and DIPs
2011-10-08 Add the code composer version of the code for the ring buffer
    Size of ring buffer is limited to best known of 100, due to odd crashing issues.
    About to add code for interfacing with the codec.
    [ring.c, ring.h]
2011-10-13 Update to the latest version of test_aud from ccs4
    Discovered reason behind crashing, DSK6713_ functions placed after variables in
    memory, without leaving enough space for the arrays, as such these instructions
    get overwritten.
    This problem unsolved, just visible in this version.
    [codec.c, codec.h, ring.c, ring.h]
2011-10-13 Add the fileload and filewrite functions for Matlab
    These functions read/write raw audio data between files and Matlab
    File structure currently written to run on ECS machines
2011-10-13 Add a Matlab function to cancel one signal from inside another
    Capable of separating two audio tracks that are mixed together, with as few as
    5000 samples (fewer untested, and at 44.1KHz sampling rate it's reasonably
    hard to test)
    Currently makes the following assumptions:
    The mixed track actually does contain the undesired sound
    'Single path' taken in mixing
    Amplitude of undesired sound in mix is the same as in the reference
2011-10-14 Modify ring buffer to no longer contain a position pointer
    Remove the position pointer, as the ring buffer is likely to be filled and read
    by two separate functions, as such it would need to contain at least 2 position
    pointers to be able to function, and to increment or decrement the pointer you'd
    need to either specify which position to adjust, or have different functions
    for each pointer.
    Now the position pointer is kept completely separate, by the function that's
    accessing the buffer, and increment and decrement now take the pointer to change
    as an argument.
    Also the ring buffer no longer contains the actual buffer, just a pointer to it.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
    [ring.c, ring.h]
2011-10-14 Changed a couple of types in the test harness for test_aud
2011-10-14 Corrected init_ring to correctly increment the position pointer
    [ring.c]
2011-10-18 Add a couple of sources
2011-10-18 Fix the problem of the ring buffer pointers not inc/decrementing
    Was due to incomplete pointer dereferencing and incomplete assignments. The
    new value was saved as a local variable and thrown away, rather than saving
    to the required memory location.
    New problem: no longer cycles over the ends correctly, appears to be
    caused by the pointers.
    [ring.c, ring.h, test.c]
2011-10-18 Fix the problem of the ring buffer not cycling over the ends correctly
    The address of the ring buffer was not being passed in by the calling function
    so none of the fields were correct, but instead carrying garbage. Individual
    function call broke, not entire setup.
    [ring.c]
2011-11-02 Add a half deconstructed circuit from the purchased headphones
    Includes a symbol for the amp, and a gafrc file
    [hp.sch]
2011-11-05 Add the Right hand half of the reverse engineered headphones
    [hp.sch]
2011-11-05 Complete reverse engineering of headphones
    [hp.sch]
2011-11-05 Correct some resistor numbering on the decomposed circuit
    [hp.sch]
2011-11-05 Rework test.c to give L and R buffers, and move LED stuff into a test function
    [test.c]
2011-11-05 Correct the codec setup to pass the address of the config
    [codec.c]
2011-11-05 Add interrupt service routines for reading/writing to the codec
    The routines don't have correct, or even compilable, vectors
    Also add externs to the buffers
    [codec.c]
2011-11-06 Fill in remainder of McBSP control config
    Largely based on the filterplatform code provided in Part II C2 lab
2011-11-08 Change some settings in the data config, and correct a couple of mistypes
    [codec.h]
2011-11-08 Fix some included headers
    [codec.c, codec.h, test.c]
2011-11-08 Read and write audio data to the ring buffer
    Switches to control whether read and write are enabled
2011-11-09 Add a sheet around the reversed engineered schematic
    Including title, name, page number etc.
    [hp.sch]
2011-11-09 Add some details about the Philips SHN2500, including the schematic
2011-11-09 Ground the speaker connections
    [hp.sch]
2011-11-11 Include all the current files in the report
2011-11-14 Add a Matlab function that achieves cross-correlation manually
    Returns an array giving a good approximation to the cross-correlation of two
    arrays. Is achieved in a manner that can be easily ported to C.
    Includes 3 different methods, 2 of which are commented out, either due to
    producing errors when running, or due to taking far too long to complete. While
    not optimal, the last (uncommented out) method will function in a short length
    of time (currently ~0.3 seconds for arrays of 5000 samples and max delay of
    +/- 200)
2011-11-15 Correct a couple of name errors in cancel function using ringbuffers
    [sigproc.c]
2011-11-15 Fix some header includes
    [codec.c, codec.h, sigproc.h]
2011-11-16 Rework the reading/writing to the codec
    Now reads both left and right, but only plays back one at a time
    [test.c]
2011-11-16 Correct some whitespace in the wave function
    [test.c]
2011-11-16 Change some types for storage of left and right of in and out separately
    Only declarations modified, code not always corrected to suit
    [ring.c, ring.h, sigproc.c, sigproc.h, test.c]
2011-11-16 Add a function to reset the aic23 codec
    [codec.c, codec.h]
2011-11-16 Correct some typing errors in test.c
    [test.c]
2011-11-28 Fix some whitespacing in the codec registers #define's
    [codec.c]
2011-11-28 Mask the unneeded part right output to prevent it from interfering with the left
    There was distortion on the left output. This seemed to be caused by the
    undefined stuff in the right output (the top 16 bits of the 32bit output)
    were interfering with the left. Masking off the top 16 bits stops this.
    [test.c]
2011-11-28 Add a section about PCBs to the future plans section of report
2011-12-02 Fix the sigproc calls to inc_ring
    They previously passed the address of the address of the ring, which had some
    interesting effects. Solved this now. Also made the result increment
    [sigproc.c]
2011-12-02 Fix some issues to do with the size of the array used for the crosscorrelation
    Made it run up to the actual max delay.
    dPeak would treat the result from the crosscorrelation as having the size
    of the ringbuffer, rather than the size of the resultant array.
    [sigproc.c]
2011-12-02 Fix some type discrepancies with the length passed into crosscorr
    The types of int16_t and int were causing innaccurate values to be passed in
    as the result wasn't cast correctly from one to the other
    [sigproc.c, sigproc.h]
2011-12-02 Move the crosscorr resultant array to a global variable
    I was getting odd crashes inside square root, apparently caused by this
    overflowing the stack. Making this global solves this problem.
    [sigproc.c]
2011-12-02 Brought the CCS code up to date
    Currently takes 8 seconds for a full cancel cycle
2011-12-10 Add a couple of sections to the background reading chapter
2011-12-10 Add a couple of chapters of one of the sources as individual sources
    They have been placed beneath the book the come from in the sources file
2011-12-10 Reposition the schematic of the Philips Headphones.
2011-12-11 Add a couple of sources to the ANC headphones section
2011-12-11 Add further explanation as to the benefits of the use of a PCB
2011-12-13 Rotate the schematic and gannt charts and place on individual pages
2011-12-13 Merge the mean function into the main code
    Severly reduces clock cycles and time taken as no longer loops through the
    entire buffer
    [sigproc.c, sigproc.h]
2012-02-03 Add some files for schematics, split into suitable sections
2012-02-03 Add the schematics directory to the readme
2012-02-03 Add some I/O ports to the analogue schematic
    [analogue.sch]
2012-02-03 Add some I/O pins to the power schematic
    [power.sch]
2012-02-06 Brought the CCS4 code up to date
    Only change seems to be buffer sizes
    This version is believed to work with a delay between samples of 8s
2012-02-10 Add the DSP symbol to the dsp schematic
    [dsp.sch]
2012-02-11 Add a file to contain listings of all components used
    Currently contains the codec, dsp and a selection of capacitors
2012-02-11 Add a projectrc file for the dsp
    Problem at this point, the BGA footprint apparently dislikes working.
    It does not appear to exist...
2012-02-11 Add the codec symbol and associated capacitors and connections required by it
    [codec.sch]
2012-02-11 Add a projectrc file for the codec schematic
2012-02-11 Add Ground connections to all of the DSP Vss pins
    [dsp.sch]
2012-02-11 Add the CVdd and DVdd connections to the DSP
    [dsp.sch]
2012-02-11 Connect the necessary RSV connections to CVdd and Vss
    [dsp.sch]
2012-02-11 Add a JTAG header for the DSP
    [dsp.sch]
2012-02-11 Add a 10K resistor to the component lib
2012-02-11 Add a pull up resistor to the /RESET pin of the DSP
    [dsp.sch]
2012-02-11 Create the 14 pin JTAG header symbol for the JTAG port
    WARNING!
    This symbol is required by a previous commit
    ae4c78a1aa70c478035aa82e41ff69f69da740aa
    If attempting to checkout between these two commits be careful of the use
    of this symbol
    WARNING!
2012-02-13 Add input and output connections compatible with hierachy
    Converted all previous IO symbols to the ones necessary for the hierachy
    Brought in a power and ground connection pin
    [codec.sch]
2012-02-14 Find an appropriate header for the JTAG and set the footprint to suit
    [dsp.sch]
2012-02-14 Add a symbol for a voltage regulator
2012-02-14 Flesh out the power schematic
    Add the voltage regulators (also located online) and surrounding circuitry
    (also located online), and connect them up to the I/O. Covers both the 3.3V
    voltage rail and the 1.2V rail
    [power.sch]
2012-02-14 Add appropriate power hierachy connections to the DSP schematic
    [dsp.sch]
2012-02-14 Add the audio I/O connectors and the codec to the overview
    The audio I/O does not have a footprint or defined style yet
    [overview.sch]
2012-02-14 Add a hierachial symbol for the power
2012-02-14 Add the power symbol to the overview schematic
    Also connect it to an input connector and to the codec
    [overview.sch]
2012-02-14 Connect the output of the codec to the headphones connector
    [overview.sch]
2012-02-15 Add the McBSP related ports to the DSP schematic
    [dsp.sch]
2012-02-15 Create a symbol for the DSP schematic hierachical effects
2012-02-15 Add a file showing the connections for McBSP relating to pins
    This data is taken from the DSK6713 schematics being backtraced
2012-02-15 Add and connect the DSP symbol to the overview
    Add the DSP symbol
    Connect the power rails
    Make the McBSP connections
    Add the pullup and series resistors for these connections
    [overview.sch]
2012-02-15 Add a 33R resistor to the component list
2012-02-15 Give footprints to the pullup and series resistors relating to the McBSP
    [overview.sch]
2012-02-15 Add a missing footprint
    [overview.sch]
2012-02-16 Change to the QFP package for the DSP
    [dsp.sch]
2012-02-16 Change to the JTAG header with the correct pin layout
    Numbering going across rows before down columns rather than down columns
    then across rows
    [dsp.sch]
2012-02-16 Change to the TI standard JTAG header layout
    As taken from the TMS320C6713 DSK Technical Reference manual
    From Spectrum Digital
    Includes adding EMU[01] connections
    [dsp.sch]
2012-02-16 Remove an unnecessary power net from the JTAG header
    [dsp.sch]
2012-02-16 Add some pull-up/down connections to the DSP
    Especially on the RSV (reserved) pins
    [dsp.sch]
2012-02-16 Add come pullup connections on the McBSP ports
    Also add them on the I2C0 port
    [dsp.sch]
2012-02-16 Add a timer to the component library
2012-02-16 Fix the clock pin usage on the DSP pins
    Removed CLKOUT and pulled CLKMODE0 up
    [dsp.sch]
2012-02-16 Change the CLKMODE0 pullup resistor to 1K
    Includes adding it to the library
    [dsp.sch]
2012-02-16 Add some footprints to the library
    Somehow I'd missed adding them previously, now appended them to:
    WM8988 Codec
    LM1117* Voltage Regulators
    BU2796 Clock
2012-02-16 Add a 8pF capacitor to the library
2012-02-16 Add the clock and surrounding circuitry into the codec schematic
    [codec.sch]
2012-02-16 Add a name value to the codec symbol
    [codec.sch]
2012-02-16 Add a jumper to gate the 12MHz clock to the codec
    [codec.sch]
2012-02-16 Disconnect the 12MHz clock output from the DSP CLKOUT
    [overview.sch]
2012-02-16 Add the capacitors for the common mode feedback on the codec
    Connections HPCOM and LCOM
    [codec.sch]
2012-02-16 Add source values to the hierachical symbols in overview
    [overview.sch]
2012-02-16 Fix some refdes fuzz in power
    One of the terminals was incorrectly labelled and another was poorly positioned
    [power.sch]
2012-02-16 Change the pin labelling to not include spaces or '+'s
    They seemed to be causing problems with refdes_renum
    [power.sch]
2012-02-17 Add I/O to the signal conditioning amplifier
    [analogue-sig-cond-amp.sch]
2012-02-17 Add a 8R resistor to the library
2012-02-17 Add a dual low power opamp to the library
2012-02-17 Make the signal conditioning stereo and add a symbol for it
    The signal conditioning has gone stereo to facilitate the use of the dual
    op-amp chip, easier to deal with routing.
    [analogue-sig-cond-amp.sch]
2012-02-17 Fix a pin numbering issue with the signal conditioning symbol
2012-02-17 Change to appropriate I/O connections on the analogue schematic
    Now also accounts for wanted sound
    [analogue.sch]
2012-02-17 Populate the analogue schematic
    Add instrumentation amplifiers to add a wanted audio signal to the 'heard'
    sound. This is to introduce a music (etc.) feed to be heard regardless,
    without interfering with the headphone amplification required.
    Add the signal conditioning blocks
    Modify the I/O connections to appropraite symbols
    [analogue.sch]
2012-02-17 Modify the overview schematic
    Remove accidentally added refdes values (easier to correct manually than trace
    and revert)
    Add a third headphone jack for a wanted sound source
    Add the analogue section
    [overview.sch]
2012-02-17 Populate most of the signal conditioning amplifier
    Based on a low pass filter followed by a voltage follower
    Not included all the components of the low pass filters, nor given them values
    [analogue-sig-cond-amp.sch]
2012-02-18 Add the second lowpass filter to the signal conditioning amplifier
    [analogue-sig-cond-amp.sch]
2012-02-18 Add the components for the signal conditioning
    An 8K2 Resistor
    A 1nF Capacitor
    Also add a Ω symbol to another line for prettyness
2012-02-18 Remove the op-amp from the signal conditioning amplifier
    This removes redundancy where the signal conditioning had an active buffer
    the output of which was then fed into the instrumentation amplifier which has
    a very high input impedance, as high as the previous buffer
    [analogue-sig-cond-amp.sch, analogue.sch]
2012-02-18 Modified some values on the hierarchical components
    In an attempt to get refdes_renum to work
    [analogue.sch, overview.sch]
2012-02-18 Rename some pin symbols for the codec
    To cope with refdes_renum breaking when a refdes begins with '+'
    [codec.sch]
2012-02-18 Add 8Ω resistors to the headphones
    [overview.sch]
2012-02-18 Add some jumpers and footprint details to overview
    Add jumpers isolating power, audio I/O, and codec from the analogue
    Add connector footprints
    [overview.sch]
2012-02-18 Revert "Add some jumpers and footprint details to overview"
    This reverts commit 9d9ed5aaa356876e57dcf1749005a04942032b6a.
    [overview.sch]
2012-02-18 Add some jumpers and footprint details to overview
    Add the jumper headers to the library
    This is identical to the previous reverted commit, except it includes the
    jumper header being added into the library
    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
    [overview.sch]
2012-02-18 Add some missing footprints
    [analogue.sch, codec.sch, dsp.sch, overview.sch, power.sch]
2012-02-18 Modify some footprints so they actually exist
    [analogue.sch, codec.sch, dsp.sch, power.sch]
2012-02-18 Connect the 3.3V rail to the Amp voltage rail
    [power.sch]
2012-02-18 Add component numbering
    [analogue-sig-cond-amp.sch, analogue.sch, codec.sch, dsp.sch, overview.sch, power.sch]
2012-02-18 Add a power LED and a couple of LEDs to the DSP
    [dsp.sch, power.sch]
2012-02-18 Add a power entry port
    This is just a 2 pin header that will not be populated, in order that an
    appropriate power source can be used for purpose
    [overview.sch]
2012-02-18 Create a footprint for the 12MHz Crystal
2012-02-18 Add the footprint attribute to the crystal
    [codec.sch]
2012-02-18 Remove the LRCOUT pin from the DSP
    Add a netname to label the purpose of the pin
    [dsp.sch]
2012-02-18 Add capacitors to the Vdd lines of the DSP
    Numbers appropriate to 1 10uF capacitor in opposing corners and:
    CVdd DVdd
    3 5,9
    11,14 25
    22,29,35 44,47
    40,43,46 55,58,65,72
    50,51,53 84,87
    60 98
    67 107,114
    80 126
    89 141
    96 162
    104,105 183,188
    116 206
    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
    [dsp.sch]
2012-02-18 Add a CLKOUT pin to the DSP schematic
    Added to suit the symbol, is grounded so is essentially useless
    Can be tidied up later
    [dsp.sch]
2012-02-18 Fix the pin numbering on the ABLS footprint
    Both pins were previously pin 1, they are no split to pin 1 and pin 2
2012-02-18 Add a footprint for the headphone cables to be soldered to
    [overview.sch]
2012-02-18 Add a stereo jack footprint
2012-02-18 Add a stereo jack to the library, and apply it to the noise input
    [overview.sch]
2012-02-18 Create the PCB
    WOOO!!!
    This is only the 101st hardware commit...
    [overview.pcb]
2012-02-19 Spread out the components and start laying copper
    Group together the various subsystems (to a degree)
    Lay copper for the power and for the audio IO
    [overview.pcb]
2012-02-19 Lay some of the copper for the codec
    [overview.pcb]
2012-02-19 Remove a couple of unneeded components
    The capacitors for the line signal are not required, so have been removed
    [codec.sch]
2012-02-19 Change the pin usage on the amp-codec jumper
    To make routing easier, all the lines crossed between the codec and the jumper
    so by swapping the pins now none of them cross, amp side unknown
    [overview.pcb, overview.sch]
2012-02-19 Continue laying out the PCB
    Add a DVdd ring for the DSP
    Reposition and lay connections for some more of the audio/codec
    [overview.pcb]
2012-02-19 Lay some more power related track for the DSP
    Side note: There seems to be some form of odd netlist issue where the grounds
    and some other links are not connected properly. Specifically this problem
    appears to be largely based around the power subsystem, with incorrect
    grounding and output connections
    [overview.pcb]
2012-02-19 Lay some more of the audio tracks
    [overview.pcb]
2012-02-20 Further route audio and DSP power
    [overview.pcb]
2012-02-20 Further the routing
    Connect codec to DSP
    Connect amp to codec
    Connect remainder of amp together
    [overview.pcb]
2012-02-20 Add some more power routing to the DSP
    [overview.pcb]
2012-02-20 Finish routing all but some ground connections
    Hoping that when I add the ground planes they'll connect
    [overview.pcb]
2012-02-20 Resize board and add ground planes
    [overview.pcb]
2012-02-20 Join ground lines with the planes and add thermal conns on the vias
    [overview.pcb]
2012-02-20 Add previously unconnected ground lines
    [overview.pcb]
2012-02-20 Join another line to the ground plane
    [overview.pcb]
2012-02-20 Fix a couple of DRC errors
    [overview.pcb]
2012-02-20 Add some more ground plane sections
    [overview.pcb]
2012-02-20 Move some decoupling resistors
    [overview.pcb]
2012-02-20 Reposition the silk screen component numbers
    For ease of reading and neatness
    [overview.pcb]
2012-02-20 Remove a patch of unconnected ground plane
    [overview.pcb]
2012-02-20 Remove another unconnected ground plane
    [overview.pcb]
2012-02-20 Widen the power tracks for the Amp and the Codec
    [overview.pcb]
2012-02-20 Widen some of the DVdd and CVdd tracks
    [overview.pcb]
2012-02-20 Widen some more of the DVdd and CVdd lines
    Basically no others can be widened without MAJOR rerouting
    [overview.pcb]
2012-02-21 Fix a mis-spacing on the HP Connector
    One of the pads was 1mm too far along, the end line was also too far over
2012-02-21 Remove the sticky out bit of the headphone jack
    So it can sit on the edge of the PCB
2012-02-21 Add a revision 0 copy of the PCB to its own directory
    For ease of access
    [overview_r0.pcb]
2012-02-21 Reset the PCB back for rework with respect to power
    [overview.pcb]
2012-02-21 Group the Power and Codec, and lay the power tracks
    [overview.pcb]
2012-02-21 Start placing decoupling capacitors around the DSP
    [overview.pcb]
2012-02-21 Add 8 new decoupling capacitors for the DVdd rail
    [dsp.sch, overview.pcb]
2012-02-22 Add some more power connections, including decoupling capacitors
    [overview.pcb]
2012-02-22 Add 2 more capacitors on the CVdd rail for the DSP
    [dsp.sch]
2012-02-22 Lay some more power tracks and coupling capacitors
    [overview.pcb]
2012-02-22 Remove 3 spare DVdd decoupling capacitors
    [dsp.sch, overview.pcb]
2012-02-22 Lay some more power connections
    [overview.pcb]
2012-02-22 Connected up the JTAG header
    [overview.pcb]
2012-02-22 Rework the JTAG header connection, and add some other components
    Rotated the JTAG header and re-connected it to the necessary pins
    Add the remaining components that connect to that side of the DSP
    [overview.pcb]
2012-02-22 Move the JTAG header closer to the DSP and rearrange some components
    Move the JTAG in so less board space is required
    Position pull up/down resistors along the remaining edge
    [overview.pcb]
2012-02-23 Recovered the codec circuitry which had somehow self-deleted
    [overview.pcb]
2012-02-23 Position and lay out the codec
    Codec also now connected to the DSP
    [overview.pcb]
2012-02-23 Position the amplifiers and being laying tracks
    [overview.pcb]
2012-02-23 Connected the audio IO to the amp and the amp to the codec
    [overview.pcb]
2012-02-23 Resize board and add ground plane
    Also ensured all ground connections are made
    NOTE: 2 different ground planes on each side, one for digital one for analogue
    These planes only connect at the power in ground pin
    [overview.pcb]
2012-02-23 Shorten the component names in the silkscreen
    [overview.pcb]
2012-02-23 Arrange silkscreen and sign
    SUDDEN ERROR
    Everything appears to have shorted...
    SOLVED
    The renaming the components in the silkscreen also removed the link with the
    netlist file, as such no pins/pads wanted to be connected to anything
    [overview.pcb]
2012-02-27 Add a footprint for a QFN 28pin 0.45mm pitch 4mm x 4mm package
2012-02-27 Change the footprint for the codec and clock generator in the schematic
    [codec.sch]
2012-02-27 Change the pcb to the new footprints
    Codec footprint generates DRC errors
    [overview.pcb]
2012-02-27 Shorten the QFN28_4 footprint pads
2012-02-27 Place the modified footprint for the codec
    [overview.pcb]
2012-03-03 Add a zip of the sent off gerber files
2012-03-06 Add a revision 1 copy of the PCB
    [overview_r1.pcb]
2012-03-30 Add a matlab lms script that filters out the noise successfully
    Reads in two audio files
    Sums them together to create the noisy signal
    Uses matlabs built in LMS to filter it out
2012-04-19 Add an appendix to show costings for the PCB
2012-04-19 Add the rest of the components to the PCB costings
    Yet to add the headphones or JTAG cable
2012-04-19 Add a section to discuss the PCB design
2012-04-19 Add titleblocks to the schematics
    [analogue-sig-cond-amp.sch, analogue.sch, codec.sch, dsp.sch, overview.sch, power.sch]
2012-04-20 Add some vague details about the schematics
2012-04-20 Fix the schematic numbering to be 6 pages total
    [analogue-sig-cond-amp.sch, analogue.sch, codec.sch, dsp.sch, overview.sch, power.sch]
2012-04-20 Add images of the schematics and include them in the report
    Also add a description relating to the analogue implementation
2012-04-21 Add an appendix to hold copies of the weekly tracker
    Currently just a place holder
2012-04-23 Add some details about power usage
    Including tables of the current draws
2012-04-23 Add images of each side of the PCB to the report
2012-04-24 Add a bullet point list about the PCB
2012-04-24 Add details about the PCB implementation
2012-04-25 Convert the philipsphones schematic to PDF, only show 1 channel
2012-04-27 Add sections to discuss testing, add HW testing details
    Details produced for testing the:
    power
    DSP
    codec
    Still need to do:
    DSP - JTAG ID
    Analogue
    Software (All)
2012-04-29 Add details about the DSP schematic
2012-04-29 Add the schematics to the Appendices
2012-04-30 Add the JTAG cable and headphone costs to the table
    Involved fiddling with the table headings and column widths
2012-04-30 Actually add some stuff to the PCB plan
2012-05-01 Move some testing stuff into an appendix
    Currently at 10093 words
    LMS testing still to be done
2012-05-01 Fix a couple of typos
2012-05-02 Bring in the CCS4 code, now with LMS
    LMS FUNCTIONS!!!
    Gets a tad noisy if it sits on 0 for a while, or if the noise signal
    disappears...
    I managed to make it produce a really nice electronic sound too
    (the trick is, uncomment the TAP_MAG_MAX stuff, and set it to 50)
    [codec.c, codec.h, lms.c, lms.h, sigproc.c, sigproc.h, test.c]
